lolbananana/Arduino-Data-Logger-for-Lights/images/arduiono_simulation.png

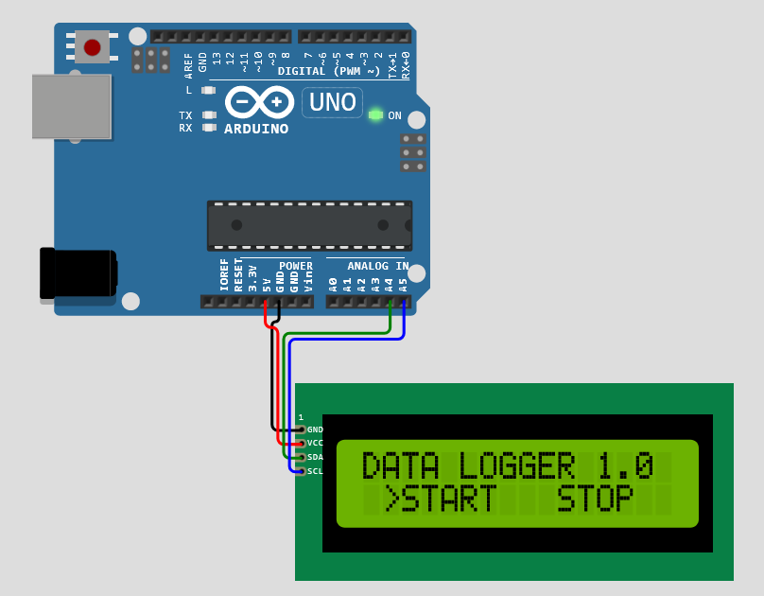
images/arduiono_simulation.png
