lolbananana/Arduino-Data-Logger-for-Lights/images/LCD_simulation.png

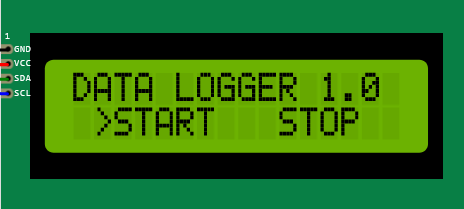
images/LCD_simulation.png
