lolbananana/Arduino-Data-Logger-for-Lights/images/temp_sensor_sim.png

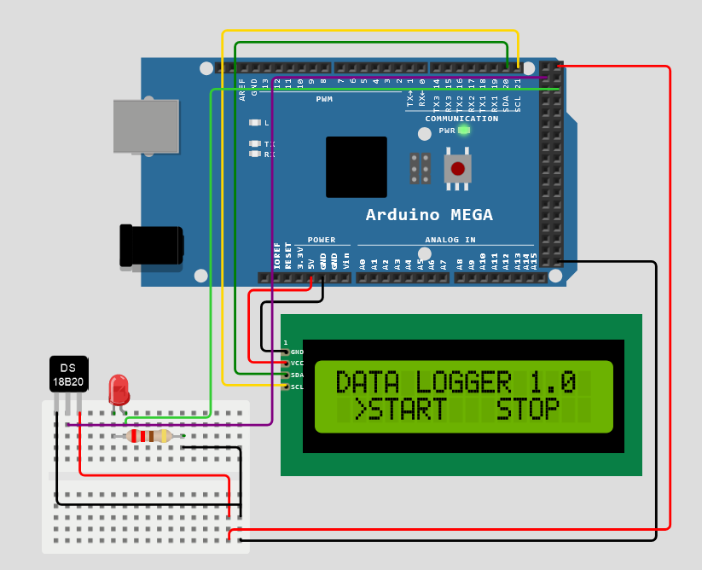
images/temp_sensor_sim.png
