lolbananana/Arduino-Data-Logger-for-Lights/Arduino Data Logger User Manual.pdf

# Arduino Data Logger User Manual

## Complete Case Build

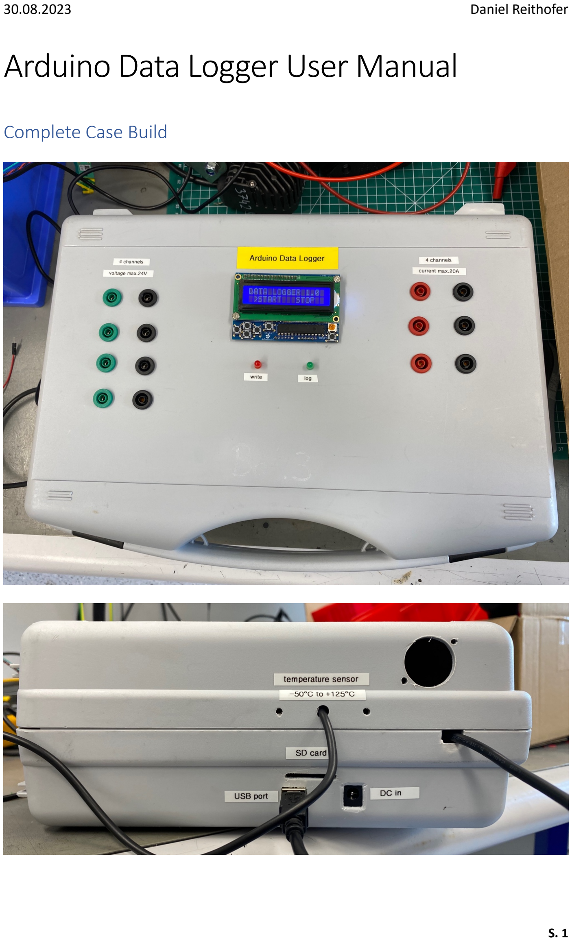
[picture p8: page 1]

30.08.2023 | Daniel Reithofer
S. 1

## How to connect your Lights

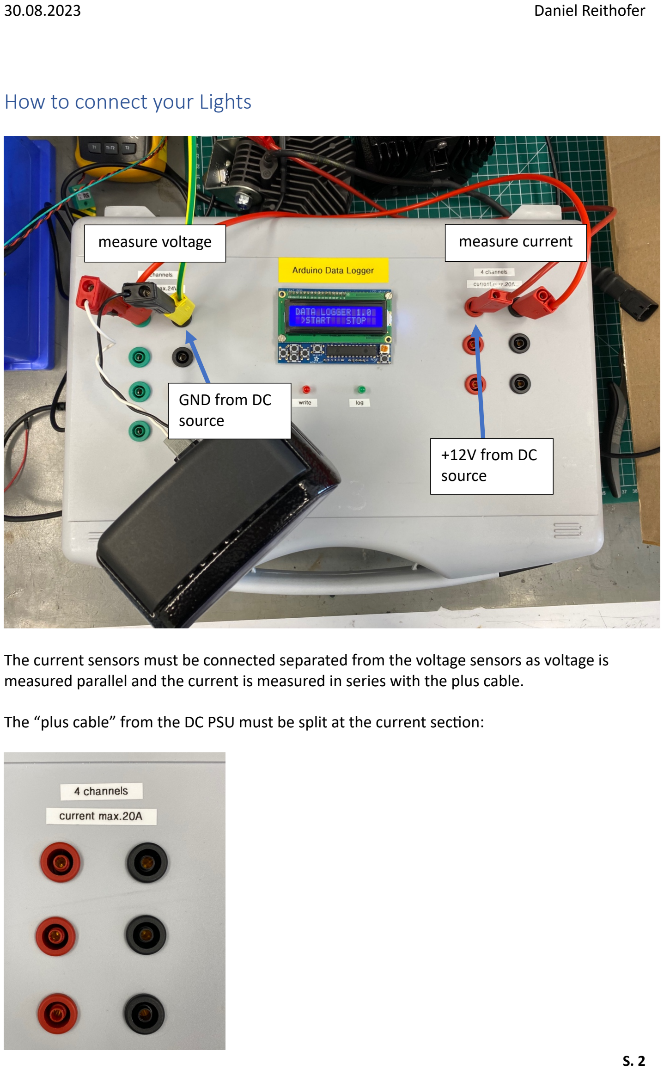
[picture p9: page 2]

S. 2

The current sensors must be connected separated from the voltage sensors as voltage is measured parallel and the current is measured in series with the plus cable.

The “plus cable” from the DC PSU must be split at the current secDon:

+12V from DC
source

GND from DC
source
measure voltage | measure current

S. 3

## How to start the Data Logger

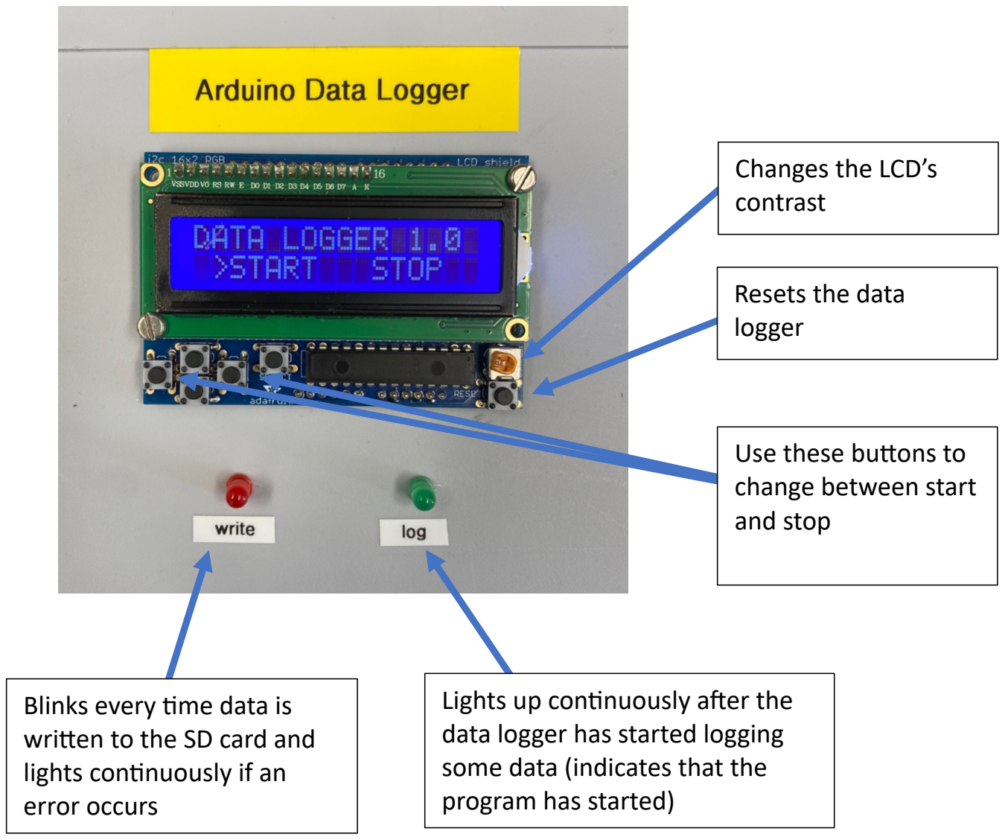
[picture p10: figure]
Use these buLons to change between start and stop; Resets the data logger; Blinks every Dme data is wriLen to the SD card and lights conDnuously if an error occurs; Lights up conDnuously aZer the data logger has started logging some data (indicates that the program has started); Changes the LCD’s contrast

## Important notes

The SD card can only be formaLed on the PC/laptop. If you can’t write data, it may be formaLed wrong or has reached the limit of 100 logger files. For further informaDon read the README.md in the GitHub repository.
